joshbrew/HEG_Arduino/Pics/HEG_Arduino_Proto.jpg

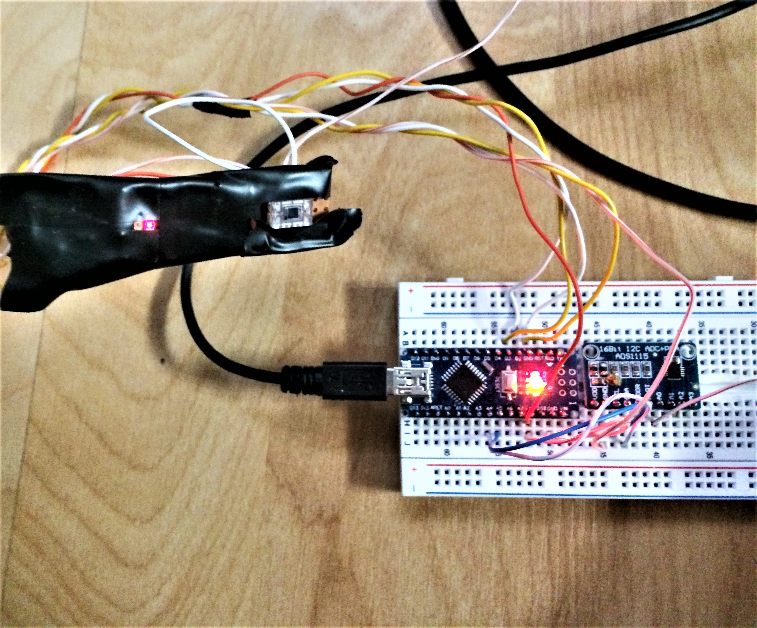
Pics/HEG_Arduino_Proto.jpg
