joshbrew/HEG_Arduino/(commit log)

2018-06-18 added a further assembled version.
2018-06-18 better prototype using a Cat5e cable and a strap
2018-06-24 simplified code testing
    also added CH340 driver for the Nano just in case that's not easy to get otherwise
2018-07-23 ESP32_HEG link added
2019-03-02 Updated, compatible with modded HEGstudio
    Make sure you set the correct LED pins. They are commented out so you have to.
    [HEG_Arduino_Code.ino]
